arroyorl/Astro-Weather/(commit log)

2024-02-14 initial commit
    ESP8266 sketch for check weather conditions for a home astronomical observatory. Gives information about cloud coverage, sky quality (mpsas), ambient temperature, humidity and pression, wind speed and rain
2024-02-15 don't change spaces by &nbsp; in handlerBoltwood() if browser is 'curl'
    fully reorganized file structure
    - directory Astro-Weather contains all arduino ESP8266 files
    - directory ASCOM bridge contains a .bat file which read data from Astro-Weather web server /boltwood and writes in a file compatible with ASCOM
2024-02-17 replaced sqm-tsl2591 library by estandard Adafruit_TSL2591 and calculate SQM in sqm module
    replaced sqm-tsl2591 library by standard Adafruit_TSL2591 and calculate SQM in sketch
    sqm-tsl2591 library replaced because it enter in loop when sensor is saturated
    [Astro-Weather.ino, sqm-tsl2591.hpp]
2024-02-18 solved issue when sensor is saturated
    [sqm-tsl2591.hpp]
2024-02-29 changes in sqm-tsl2591 and parameters web page to solve issues
    replaced formula for SQM mpsas calculation from http://www.unihedron.com/projects/darksky/magconv.php
    changed #ifdef W_SQM by W_GY906 in parameters (the section corresponds to GY906)
    [Astro-Weather.ino, parametersPage.hpp, sqm-tsl2591.hpp]
2024-03-07 updated to support resistive graphite sensor
    Defined rainabove in settings to control if rainD is true when A0 reading (rainA) is above or below threshold.
    This is needed for graphite rain sensors.
