arroyorl/Astro-Weather/(notices)

Notices in the files:
Astro-Weather/settings.h:
This program is free software: you can redistribute it and/or modify
it under the terms of the GNU General Public License as published by
the Free Software Foundation, version 3 of the License.
